ADXBD/DOMINO-A1M19003K-S/README.md

# DOMINO-A1M19003K-S
See attached PDF for assembly instrucations
