ADXBD/DOMINO-A1M19003K-S/Domino-S Lower Body.step

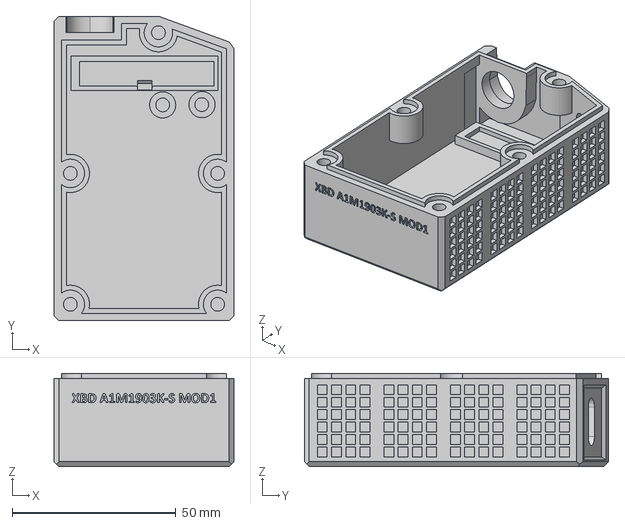
[picture p1: CAD file, 2025-05-07]
Domino-S Lower Body.step
55.0 x 93.0 x 28.5 mm
