ADXBD/DOMINO-A1M19003K-S/Domino Light Cover.step

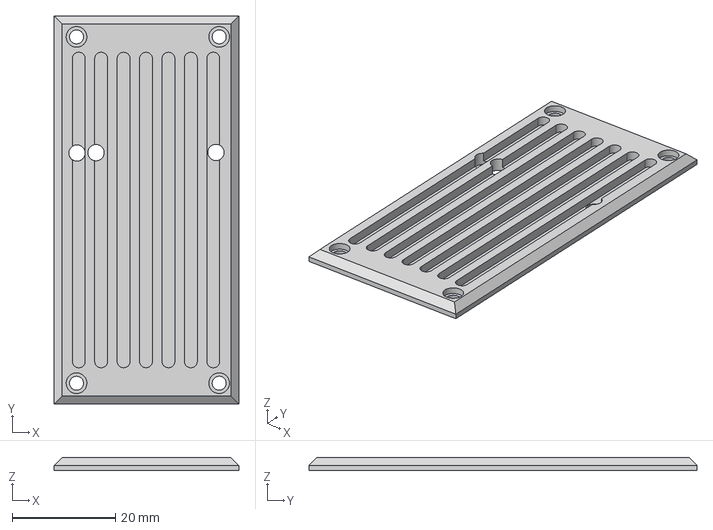
[picture p2: CAD file, 2025-05-07]
Domino Light Cover.step
35.7 x 75.0 x 2.50 mm
