ADXBD/DOMINO-A1M19003K-S/Domino Top.step

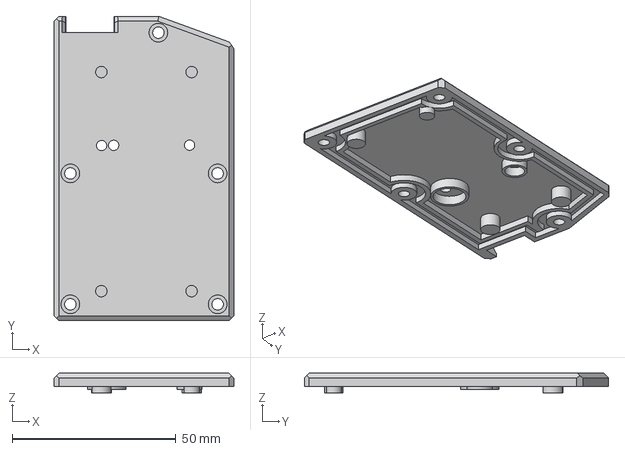
[picture p3: CAD file, 2025-05-07]
Domino Top.step
55.0 x 93.0 x 6.00 mm
