ADXBD/DOMINO-A1M19003K-S/MASTER-ALL IN ONE DOMINO- K and S.3mf

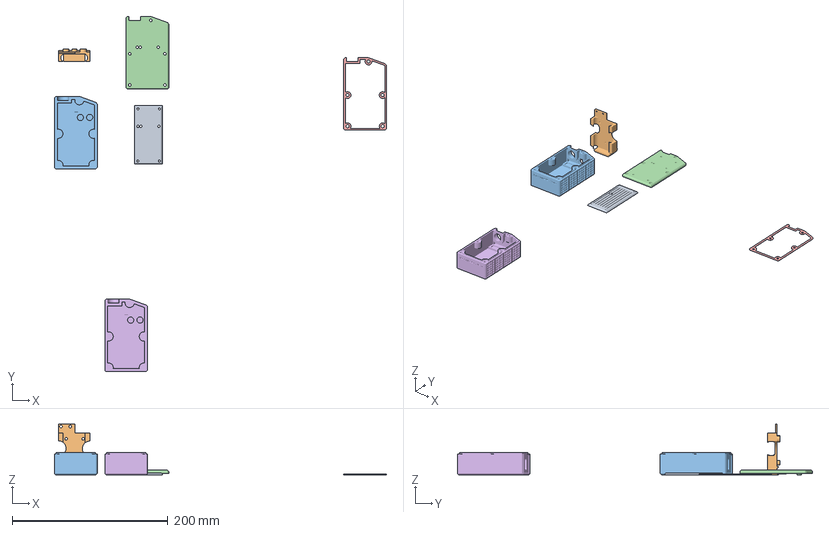
[picture p4: CAD file, 2025-05-07]
MASTER-ALL IN ONE DOMINO- K and S.3mf
426.4 x 455.9 x 65.0 mm
Domino Light Cover.step
Domino Battery Board.step
Domino Lower Body.step
Domino Top.step
TPU Gasket.step
Domino-S Lower Body.step
