ADXBD/DOMINO-A1M19003K-S/TPU Gasket.step

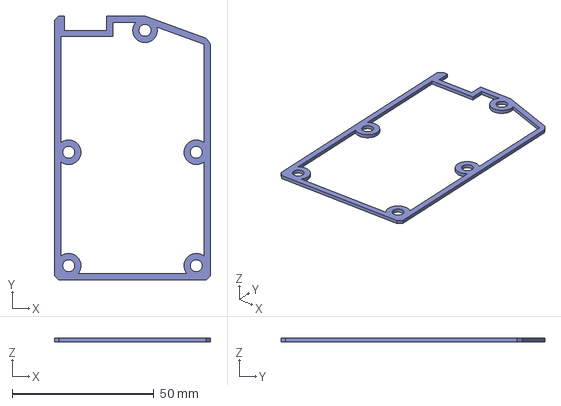
[picture p5: CAD file, 2025-05-07]
TPU Gasket.step
55.0 x 93.0 x 1.25 mm
