ADXBD/DOMINO-A1M19003K-S/Domino Battery Board.step

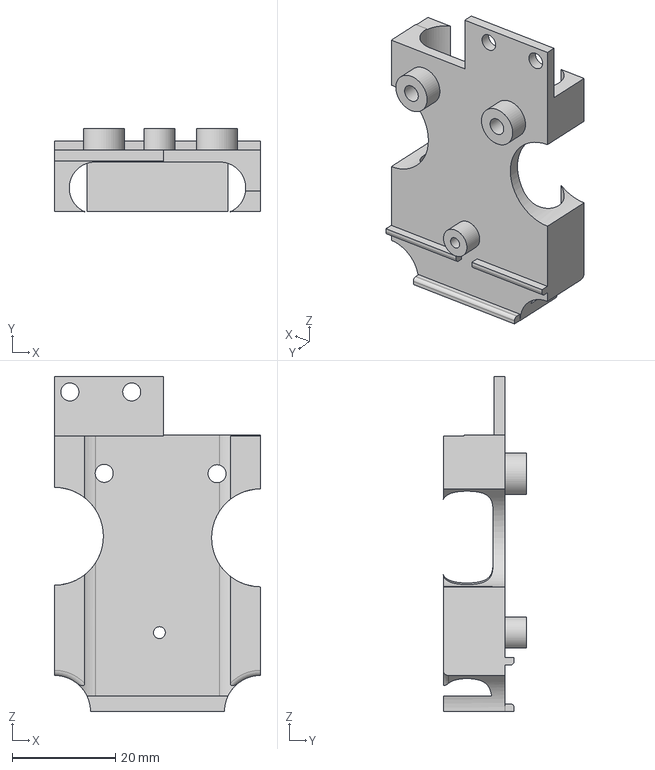
[picture p6: CAD file, 2025-05-07]
Domino Battery Board.step
40.0 x 16.2 x 65.0 mm
