ADXBD/DOMINO-A1M19003K-S/A1M19003K and K_S How to Guide v1.1.pdf

Required Material:
1. Power Button – I used one with an LED light in the switch, but a non lit version will also work (note my wiring diagram reflects the LED version)
a. LED: LINK (https://d.docs.live.net/0866be0134612a15/Desktop/i.%09https:/www.amazon.com/dp/B091CVNW4C)
b. Non LED: LINK (https://d.docs.live.net/0866be0134612a15/Desktop/i.%09https:/www.amazon.com/dp/B09BKXT1J1)
2. USBC Power Inlet – LINK (https://www.aliexpress.us/item/3256808240451244.html?srcSns=sns_More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)
3. USB-C Male 2 Wire Connection - LINK (https://d.docs.live.net/0866be0134612a15/Desktop/a.%09https:/www.aliexpress.us/item/3256807271594830.html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)

### 4. M2 x 6 Screws 5. M3 x 8 Screws

6. 2000 MaH Battery - LINK (https://www.amazon.com/dp/B08HD33ZKB?ref_=ppx_hzsearch_conn_dt_b_fed_asin_title_1)
7. Acrylic Rods 1/8 inch- LINK (https://www.amazon.com/dp/B0B4JRXKHL?ref=ppx_yo2ov_dt_b_fed_asin_title&th=1)

### 8. M2.5 * 4 * 4 Heat Inserts (6) 9. M3* 4* 4.2 Heat Insert (7)

10.Heat Shrink Tubing (Various sizes)
11.Optional: JST Connections: I wire the switch to a JST, instead of directly to the battery. This allows for quicker battery changes. My wiring diagram shows this.

### 12. Tools and Other: Soldering Iron, Solder, Wires

13.Sand Paper 800 Grit
14.Hot Glue & Hot Glue Gun
Note: This Model does not support USB-C data Transfers. The USB-C pass-through on this device is for power only. To update, you will need to remove the cover and use a USB-C Data Cable.

Step 1: Wire the Switch
Note: For this model, trimming down the wires is necessary. Take a look at step 5 below to see what the final internal assembly looks like. This will give you an idea of where to trip the switch and the JST wires.
Switch Wiring Diagram:
I wired the switch so the light is on when the power is on and plugged in and off when the power is off. I also use JST on both sides, which allows for easy and rapid battery changes.

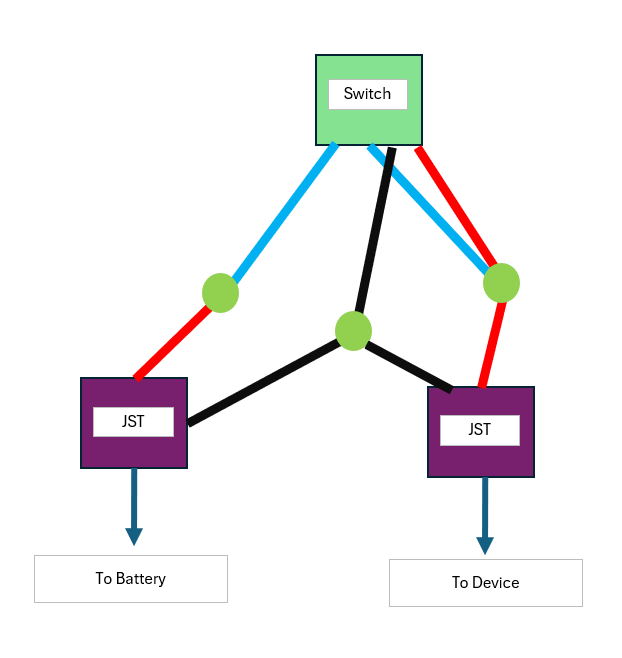
[picture p7: figure]

Step 2: Heat Inserts
Install the 4ea M2 Heat Inserts into the Front (top) and 2ea M2 Heat Inserts into the Battery Tray.

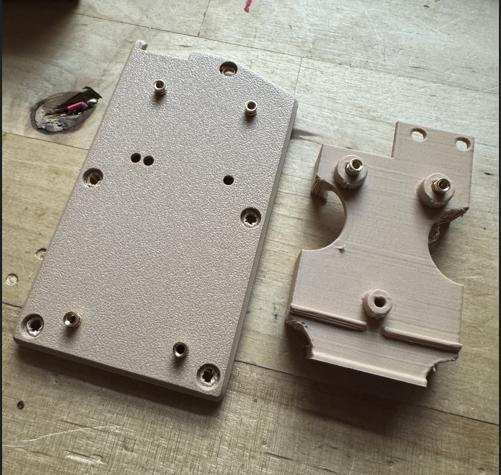
[picture p8: figure]

Next install the 7ea M3 Heat Inserts into the main body.

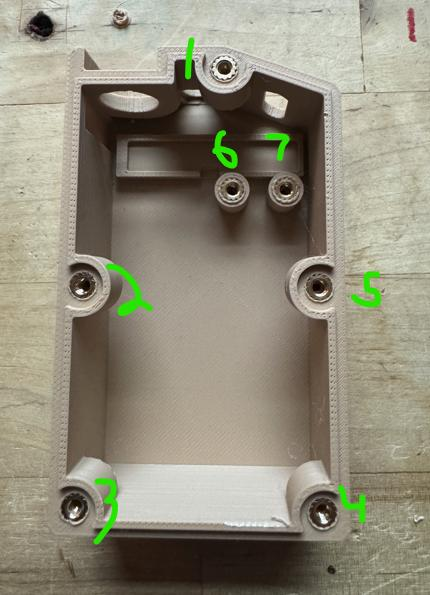
[picture p9: figure]

Step 3: Install the battery into the tray
Notice the battery wire is routed to the opposite side of the mount points.

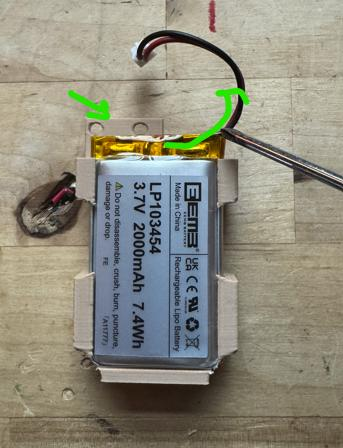
[picture p10: figure]

Step 4: Wire the power source

Cut both the USBC Power Inlet and USB-C Male 2 Wire Connection down to a shorter size.

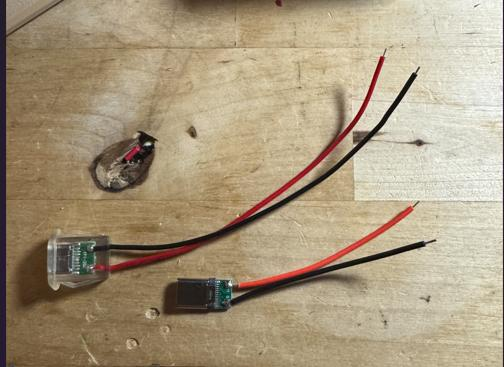
[picture p11: figure]

Before trim:

After trim:

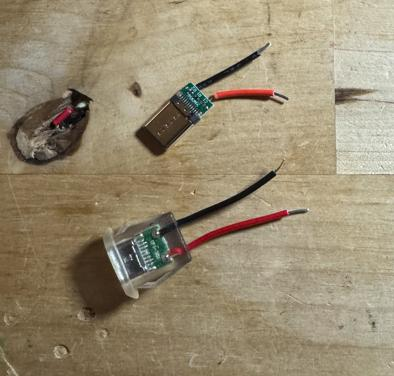
[picture p12: figure]

This is an optional step, but I prefer to install some heat shrink around the male USB component. This will protect the wires and reduce the risk of a short.

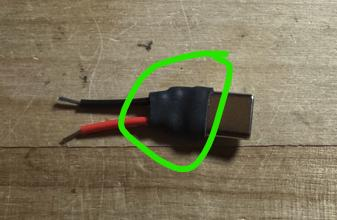
[picture p13: figure]

Next, solder the 2 components together.

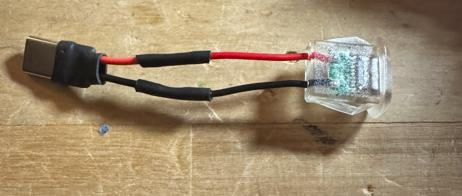
[picture p14: figure]

Step 5: Install Internal

I recommend installing the Bluetooth antenna first. (In the photo below, the battery tray is installed. Its much easier to install the antenna before anything else is installed.

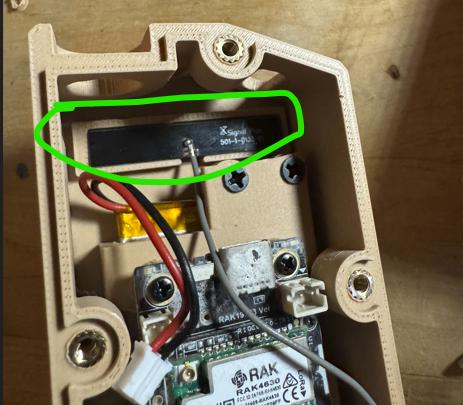
[picture p15: figure]

Next install the battery tray using 2 M3 screws to secure the board.

Next install the SMA antenna, power switch & USB-c assembly. It should look something like this.

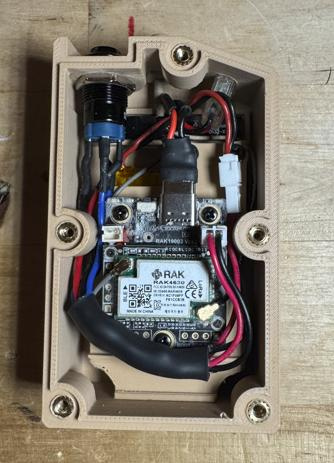
[picture p16: figure]

Notes and tips: I use a small flat-head screwdriver to tighten the power switch nut. It's too tight to get a wrench in there, and the screwdriver seems to get it tight enough.

If assembling the S model, the LoRa antenna will go onto the power board; the screenshot below notes the location of the antenna.

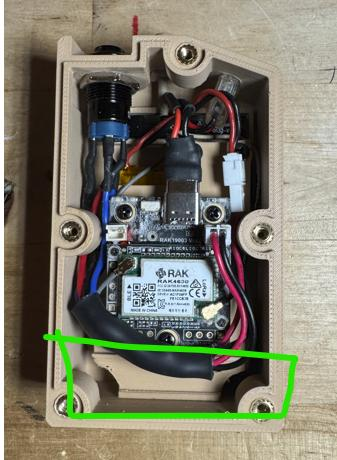
[picture p17: figure]

Ensure that your wires do not cover the board's 3 status lights. You should be able to tuck the wires under the top mount posts using a small screwdriver.

Step 6: Final Assembly

Install the gasket onto the main housing, then place the top on. Insert the rod into one of the light holes and gently push until it just touches the board. Mark the cut point. It should be around 11.5 mm. I mark the cut spot with blue tape.

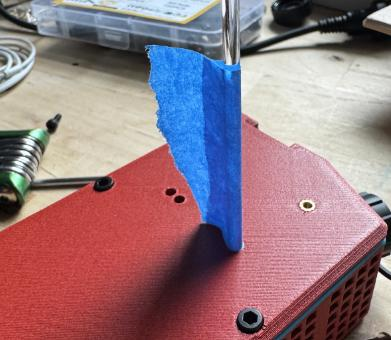
[picture p18: figure]

At this point, I cut the rod and made 3 matching smaller rods. I used a hacksaw to cut about ½ inch halfway through the rod, then I brake it.

Next, sand the rough edges using 800 grit sandpaper until each end of the rod is smooth. Insert the rods into the holes and press until flush with the top. If they don’t fit perfectly, remove them and continue sanding.
Final product should look like this.

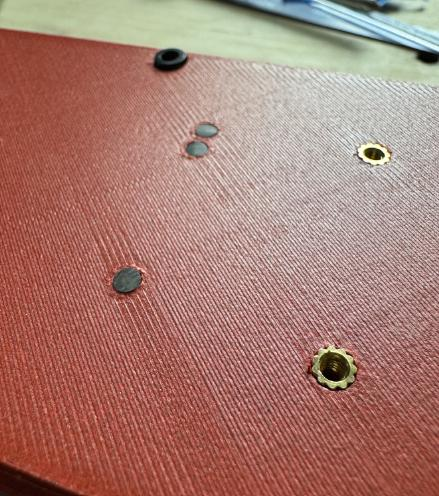
[picture p19: figure]

To finish the light rods, remove the top (keep the rods in place) flip it and hot glue the back side of the rods in place.
Note: I like to put heat shrink around the rods, but this is not necessary; I just think it looks cleaner.

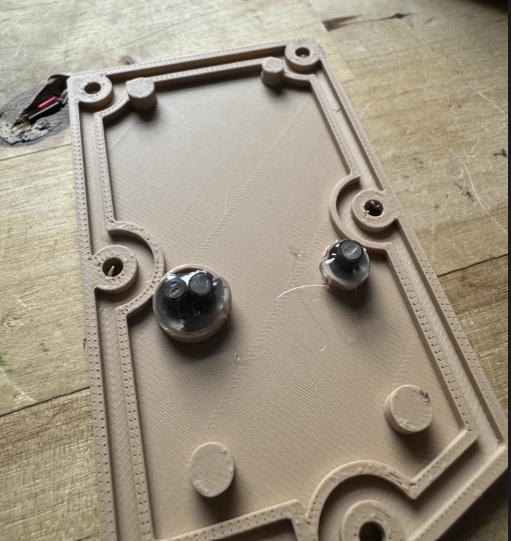
[picture p20: figure]

Finally, install the top and the front cover. This completes the build.
